harukiti82/car-to-mac/左右出力/line_car_forward/speed_bpm_table.pdf

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

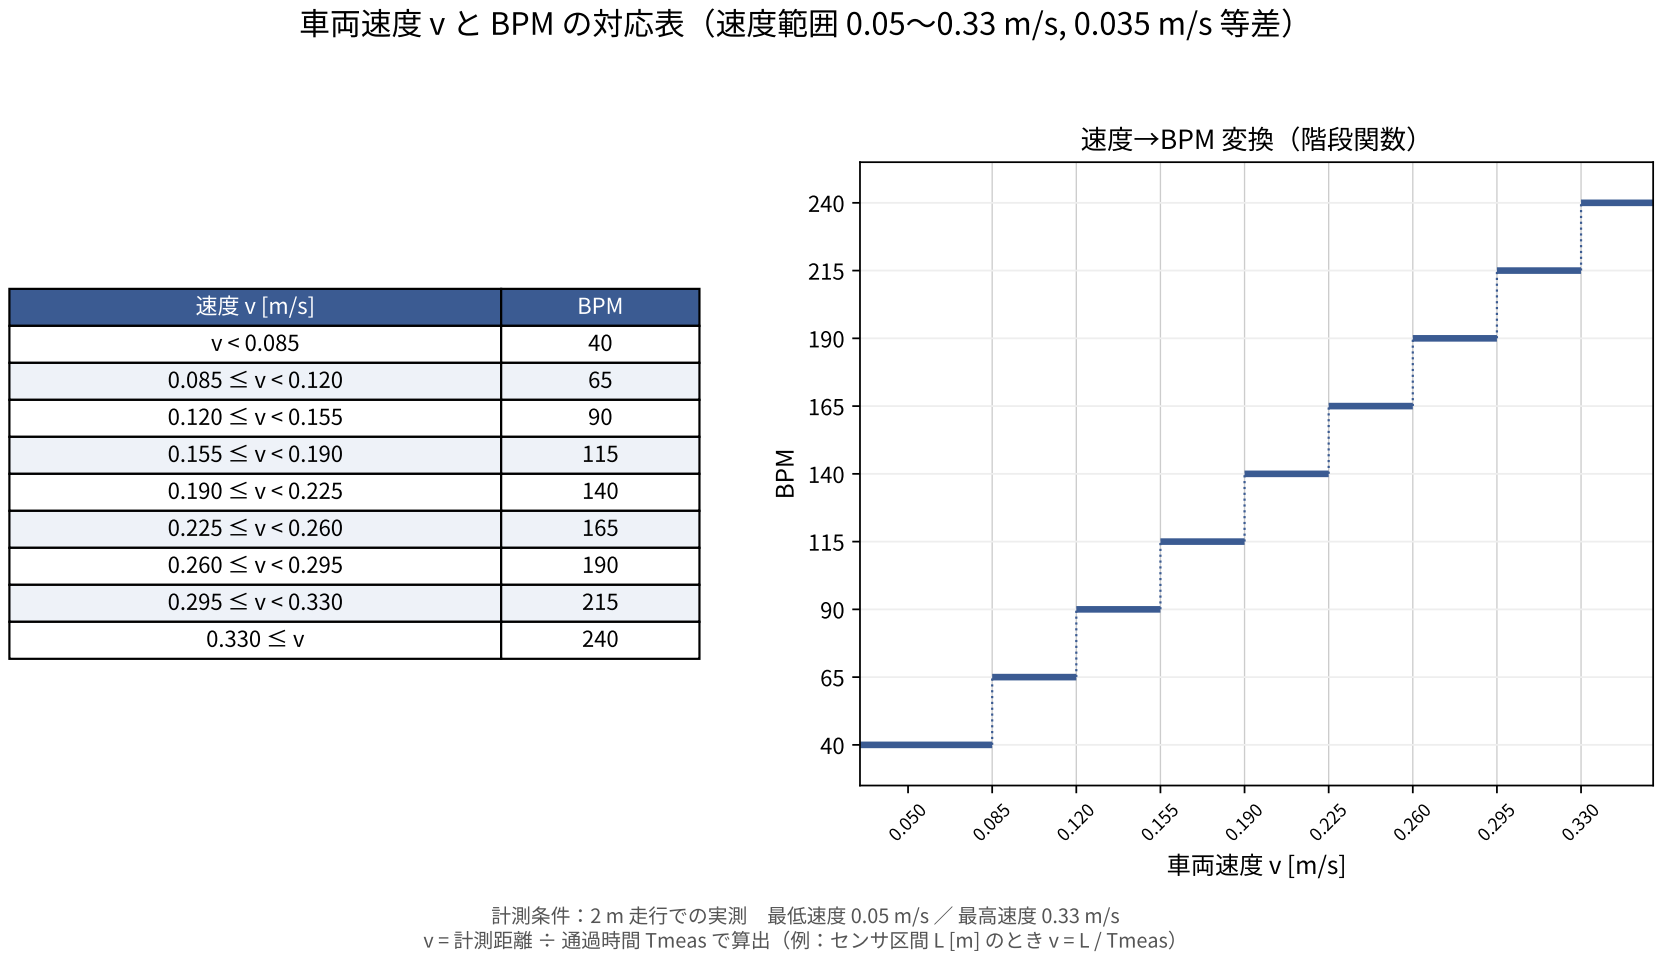
[picture p1: page 1]
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
