harukiti82/car-to-mac/(commit log)

2026-05-26 [機能追加] car_to_mac ハッカソン成果物を初回コミット
    - outputs.pde: Processing スケッチ（メイン出力）
    - line_car_uno_r4.ino: Arduino UNO R4 用スケッチ
    - line_car_test_udp/: UDP 通信テスト用スケッチ
    - 左右出力/: 左右出力用スケッチ
    - 直進/: 直進用スケッチ
    - SETUP_配線とセットアップ.md: 配線・セットアップ手順
2026-05-27 [修正] 無線時の不安定動作を3点修正
    - Serial.print を if(Serial) でガード: USB 未接続（バッテリー駆動）時に
    シリアルバッファ満杯でブロックし loop() が詰まる問題を解消
    - loop() に WiFi 再接続処理を追加: 切断後に永遠に回復しない問題を解消
    - delay(10) を追加: Servo タイマー割り込みと WiFi スタックの競合を緩和
    [line_car_realtim2.ino]
2026-05-27 [機能追加] Processingリモコン（前後・速度スライダー操作）を追加
    - 縦スライダー1本で前進／後退を操作（上=前進, 下=後退, 量で速度）
    - ドラッグ中だけ走行、離すと自動でノブが中央に戻り停止
    - STOPボタンで即時停止
    - 追加ライブラリ不要（DatagramSocket でUDP送信）
    - 20Hz 間隔で LR:n,n コマンドを送信
2026-05-27 [ドキュメント] ESP32-S3 CAM ライントレース実装設計書を追加
    line_car_realtim2.ino（2サーボ独立版）を起点に、ESP32-S3 CAM からの誤差受信と
    PD 制御でライントレースを行う設計書。Sonnet が実装する前提でピン番号・閾値・
    通信プロトコル・受け入れ条件をリテラル粒度で記載。
2026-05-27 [機能追加] 前進専用リモコン（速度維持型）を追加
    - スライダーを離しても設定速度を維持して走り続ける
    - 上端=100%, 下端=0% の前進専用スライダー1本
    - STOPボタンでノブを0に戻して即停止
    - line_car_remote と同じUDP/プロトコル構成
2026-05-27 [機能追加] 前進専用リモコンに速度の数値直接入力を追加
    フィールドをクリック → 数字キーで入力 → Enter で確定するとスライダーも連動。
    Backspace で1文字削除、Escape でキャンセル、0〜100 の範囲を自動クランプ。
2026-05-27 [修正] ESCキーの定数名誤りとウィンドウ終了の抑制を修正
    ESCAPE → ESC（Processing の正しい定数名）に修正。
    key = 0 を追加して ESC によるウィンドウ終了を抑制。
    [line_car_forward.pde]
2026-05-27 [機能追加] ライントレース実装（UNO R4 + ESP32-S3 CAM）
    設計書 DESIGN_ライントレース.md に基づく実装。
    - line_car_realtim2.ino: MODE:AUTO/MANUAL 切替、PD 制御、Serial1 受信、UDP プロトコル拡張
    - esp32s3_cam_linetrace.ino: OV2640 QQVGA グレースケール重心法でライン誤差を算出し UART 送信
2026-05-27 [機能追加] ライントレース統合リモコン（AUTO/MANUAL切り替え対応）
    設計書 §3.2 の全プロトコルに対応した Processing リモコンを追加。
    MODE:AUTO（SPDスライダー）とMODE:MANUAL（左右独立スライダー）をボタンで切り替え、
    ACK受信をリアルタイム表示する。
2026-06-14 [機能追加] 前進リモコンをBPM指定方式に変更
    speed_bpm_table.pdf の対応表（BPM 40〜240、9段階）に基づき、
    スライダー・テキスト入力の単位を速度%からBPMに変更。
    BPM→speed%のリニア変換で Arduino に送信する。
2026-06-14 [機能追加] 矢印キー↑↓でBPMステップ切り替え
    BPM_STEPSの9段階（40,65,...,240）+ 停止(0)を
    ↑↓キーで順に切り替えられるショートカットを追加。
    テキスト入力フォーカス外でも動作する。
2026-06-14 [機能追加] スペースキーで即時停止ショートカットを追加
2026-06-14 [改善] WiFi接続をAPモードに変更（Arduinoがホスト）
    外部ルーター不要でMacから直接接続可能に。IPは192.168.4.1固定。
2026-06-14 [修正] サーボ接続ピンをD9/D10に変更しデバッグ出力を追加
    PWM対応ピンに変更。サーボに送るus値を500ms毎にシリアル出力して動作確認できるようにした。
2026-06-14 [修正] Processing の接続先IPをAPモード用に変更
    Arduino をAPモード（192.168.4.1）に変更したのに合わせて更新。
    [line_trace_controller.pde]
2026-06-14 [修正] Servoライブラリを手動パルス生成に置換（WiFi AP干渉回避）
    WiFi APモードのタイマー割り込みがServoライブラリと干渉してパルスが出ない問題を、
    noInterrupts()で保護した手動パルス生成で解決。サーボ単体テストも追加。
    [line_car_realtim2.ino, servo_test.ino]
2026-06-14 [機能追加] キーボード操作のシンプルコントローラーを追加
    送信値・パルス値・ACK・送信ログをリアルタイム表示しデバッグしやすくした。
2026-06-14 [改善] Arduino側にバージョン表示とパルス値デバッグ出力を追加
2026-06-14 [改善] サーボパルス生成をFspTimerのハードウェア割り込みに移行
    loop()内でdelayMicrosecondsを使う手動パルス生成は、WiFi/UART処理で
    loop()がブロックされるとパルスが途切れモーターが動かなかった。
    50us周期のタイマーISRで50Hzパルスを独立生成し、loop()の負荷と無関係に
    安定したパルスを出すよう変更。receiveSerial1にも処理バイト上限を追加。
2026-06-14 [改善] loop先頭にハートビート診断とreceiveUDPの暴走ガードを追加
    PULSEが出ない=loopが末尾(パルス幅更新)に到達していない可能性の切り分け用に、
    loop先頭でタイマーと無関係なハートビート(loop#とg_pulse値)を出力。
    receiveUDPのwhileループにパケット数上限(4)を入れ、末尾到達を保証する。
2026-06-14 [改善] PULSEデバッグにrun/mode/leftPct/受信経過msを追加
    末尾で1500(停止)になる原因切り分け用。running・mode・leftPct・最後の
    UDP受信からの経過時間を表示し、通信タイムアウトによる停止かどうかを判定する。
